faecorrigan/Open-Source-3-axis-CNC-Touch-Probe/README.md

# Open-Source-3-axis-CNC-Touch-Probe

This is a 3 axis cnc probe, principle development is done for the Makera Carvera

Features:
wireless communication between the probe and host via raw 802.15.4 packets
OTA firmware configuration and updates
wireless charging of on board lipo battery

The current development prototype in software uses the Arduino IDE with a seedstudio XIAO nrf52840 
Final hardware will be a custom nrf52840 circuit. 

the project currently is using public libraries from:
https://github.com/Tjoms99/xiao_sense_nrf52840_battery_lib
