faecorrigan/Open-Source-3-axis-CNC-Touch-Probe/Hardware/Circuit Boards/ballBearingBoard241112/buttonCircuitBoard241112.step

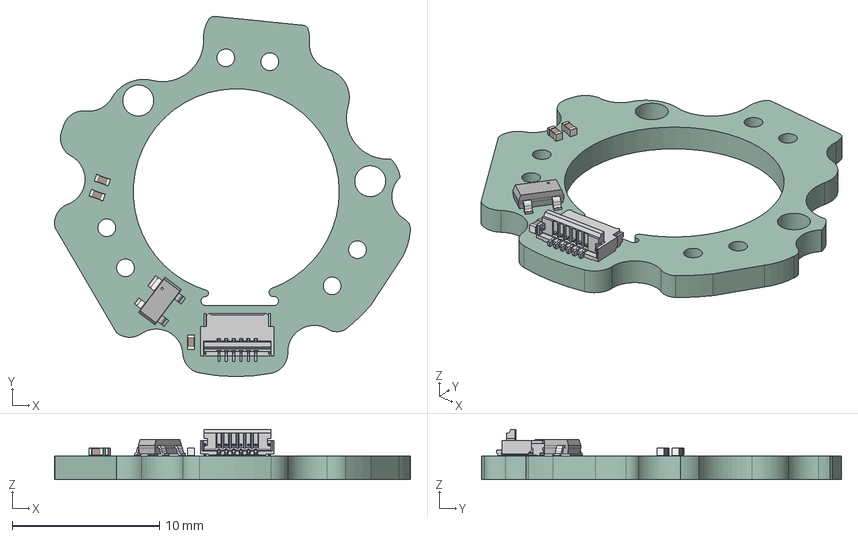
[picture p1: CAD file, 2025-11-08]
Hardware/Circuit Boards/ballBearingBoard241112/buttonCircuitBoard241112.step
24.2 x 24.5 x 3.42 mm
C_0402_1005Metric x 3
FH34SRJ-6S_ACTUATOROPEN.PRT
ballBearingBoard241112_PCB
