faecorrigan/Open-Source-3-axis-CNC-Touch-Probe/Hardware/Circuit Boards/BallBearingBoardPanelization/buttonCircuitBoard Vertical.step

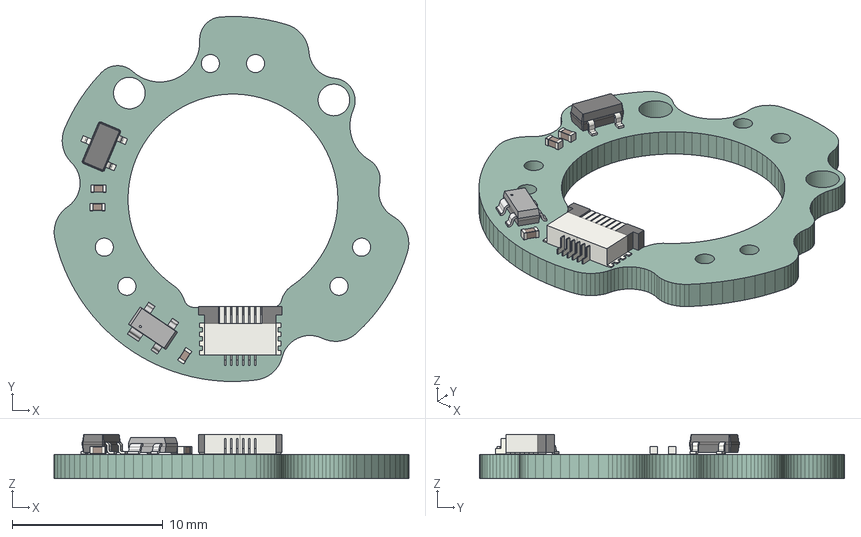
[picture p2: CAD file, 2025-11-08]
Hardware/Circuit Boards/BallBearingBoardPanelization/buttonCircuitBoard Vertical.step
23.6 x 24.2 x 2.95 mm
SC_59
C_0402_1005Metric x 3
TE_84953_6
bbsolderingTest PCB
