faecorrigan/Open-Source-3-axis-CNC-Touch-Probe/Hardware/Circuit Boards/ConnectionFPC/ballBearingFPC250213.step

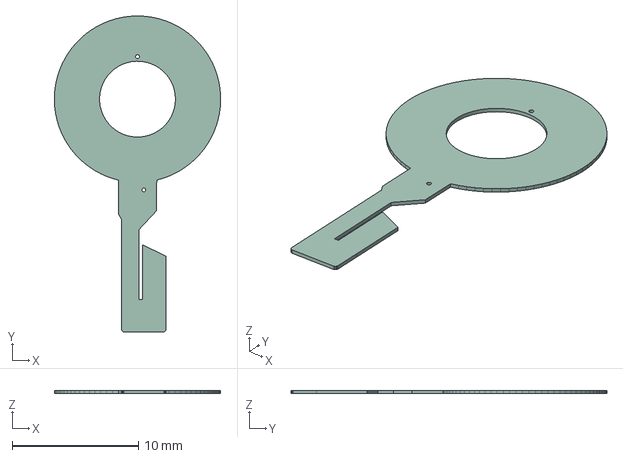
[picture p3: CAD file, 2025-11-08]
Hardware/Circuit Boards/ConnectionFPC/ballBearingFPC250213.step
13.2 x 25.0 x 0.233 mm
