faecorrigan/Open-Source-3-axis-CNC-Touch-Probe/Scratch/david/hardware/ball_coupling_test/v3_probe_ball_coupling_test.FCStd

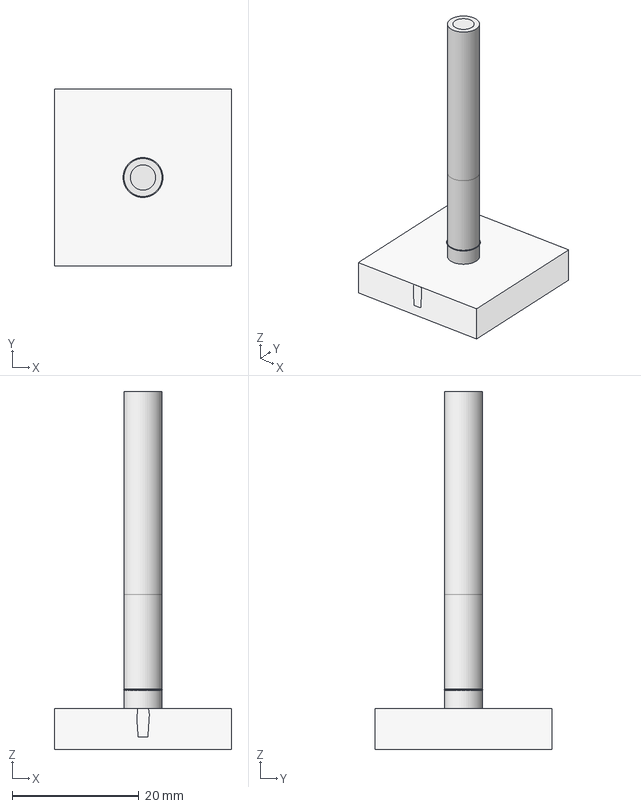
[picture p4: CAD file, 2024-04-26]
Scratch/david/hardware/ball_coupling_test/v3_probe_ball_coupling_test.FCStd
28.0 x 28.0 x 56.5 mm
Model-Body
Stock001
6mm_roughing_cut18mm
1mm_cut3mm
m2_neck6mm_threadmill
