faecorrigan/Open-Source-3-axis-CNC-Touch-Probe/Scratch/david/hardware/programming_board/v2/programming_board.FCStd

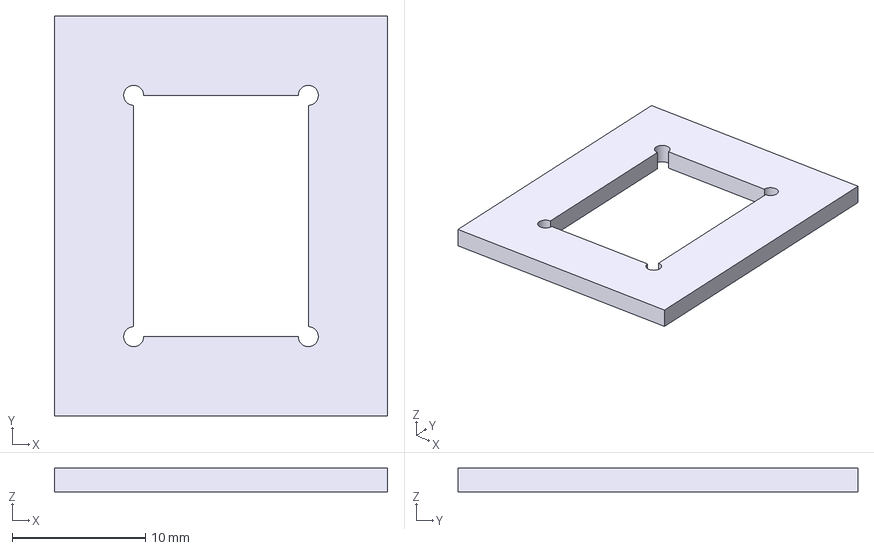
[picture p5: CAD file, 2024-06-06]
Scratch/david/hardware/programming_board/v2/programming_board.FCStd
25.0 x 30.0 x 1.80 mm
