faecorrigan/Open-Source-3-axis-CNC-Touch-Probe/Hardware/Circuit Boards/BallBearingBoardPanelization/buttonCircuitBoard241112.step

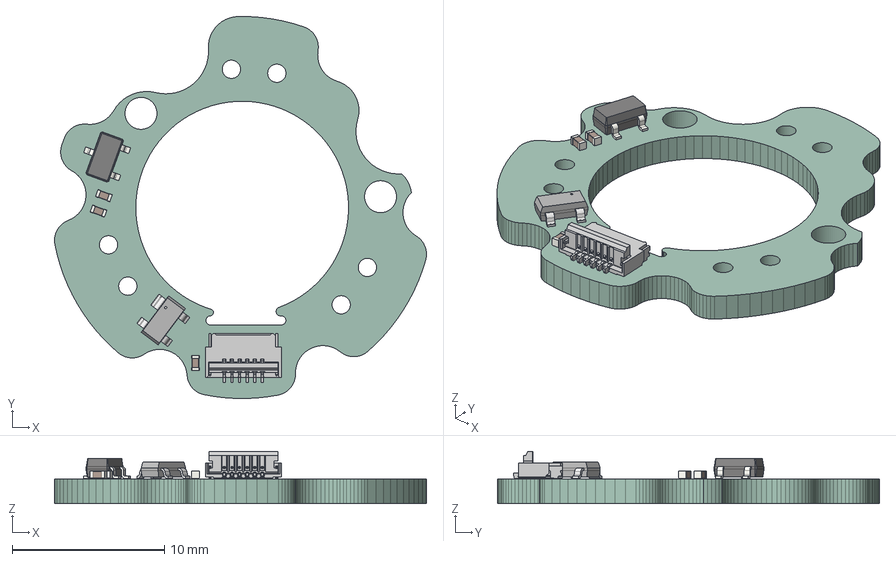
[picture p6: CAD file, 2025-11-08]
Hardware/Circuit Boards/BallBearingBoardPanelization/buttonCircuitBoard241112.step
24.5 x 25.1 x 3.42 mm
SC_59
C_0402_1005Metric x 3
FH34SRJ-6S_ACTUATOROPEN.PRT
ballBearingBoard241112 PCB
