faecorrigan/Open-Source-3-axis-CNC-Touch-Probe/Scratch/david/hardware/ball_coupling_test/V3 - Ball Holder.step

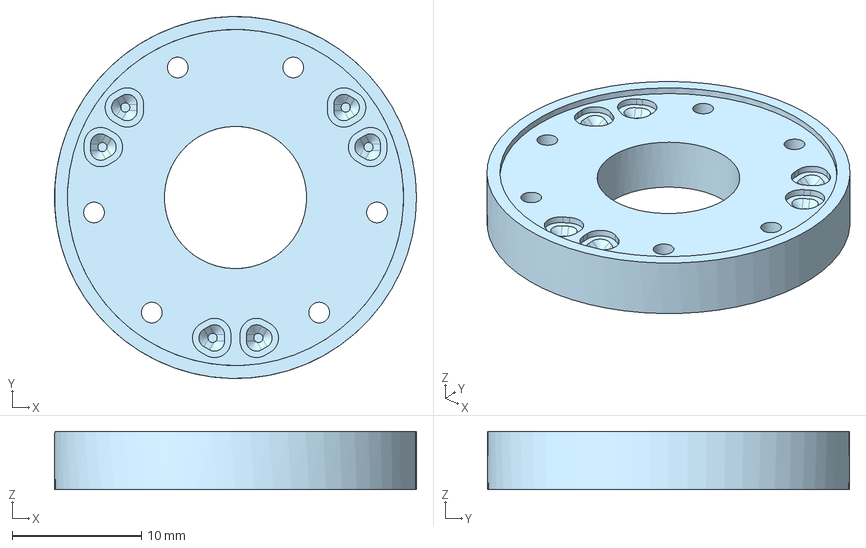
[picture p7: CAD file, 2024-04-23]
Scratch/david/hardware/ball_coupling_test/V3 - Ball Holder.step
28.0 x 28.0 x 4.50 mm
