faecorrigan/Open-Source-3-axis-CNC-Touch-Probe/Scratch/david/hardware/programming_board/v1/programming_board.FCStd

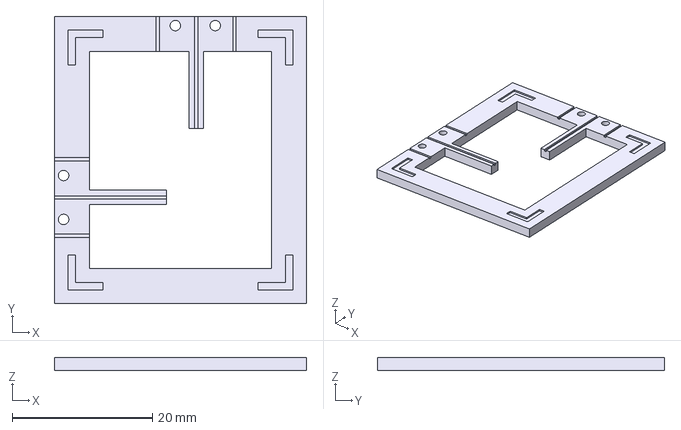
[picture p8: CAD file, 2024-06-06, an earlier design]
Scratch/david/hardware/programming_board/v1/programming_board.FCStd
36.0 x 41.0 x 1.80 mm
