faecorrigan/Open-Source-3-axis-CNC-Touch-Probe/(list of files, cad)

Other CAD files:
Hardware/Circuit Boards/BallBearingBoardPanelization/buttonCircuitBoard.step
Scratch/Fae/FusionPostProcessor/CarveraFusionPostProcessorTests.f3z
