faecorrigan/Open-Source-3-axis-CNC-Touch-Probe/Hardware/Circuit Boards/ConnectionFPC/ballBearingFPC250213.kicad_pcb

## KiCad design Hardware/Circuit Boards/ConnectionFPC/ballBearingFPC250213.kicad_pcb (2025-11-08)

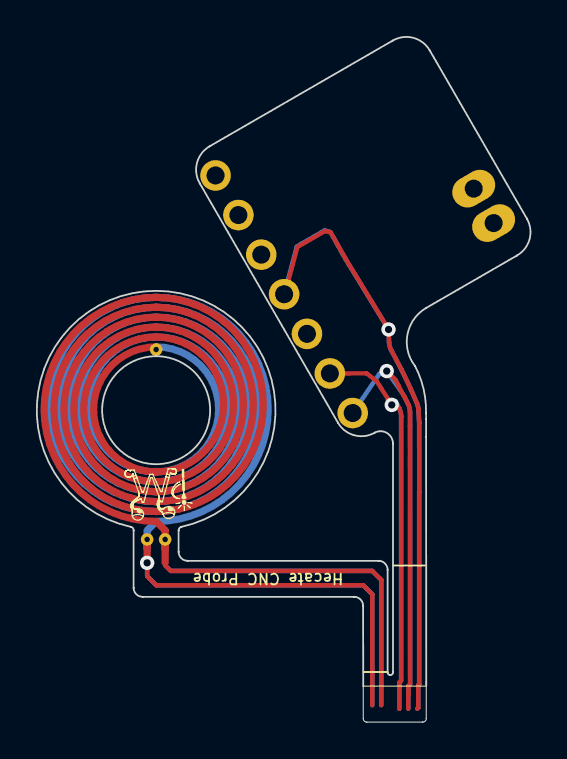
[picture p9: board ballBearingFPC250213.kicad_pcb from above]

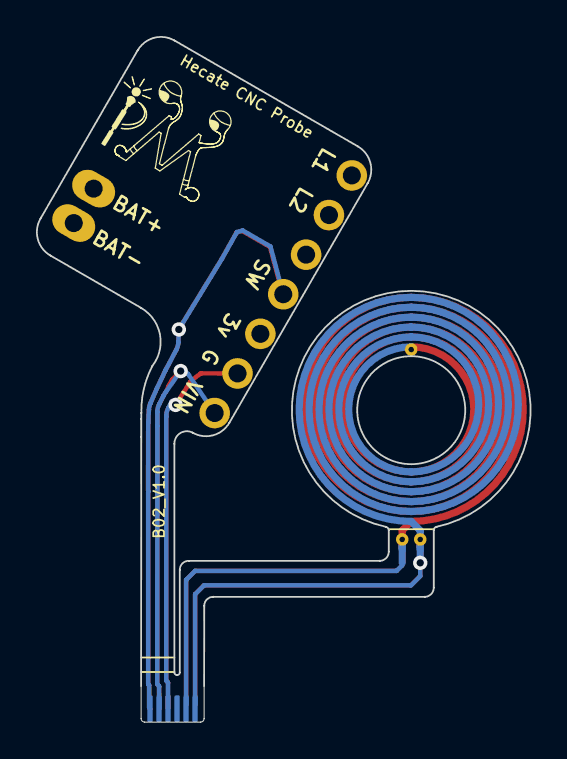
[picture p10: board ballBearingFPC250213.kicad_pcb from below]

Board: 2 copper layers, 27.4 x 38.1 mm, 11 parts (11 on the bottom side), 5 nets.

Parts:
J1: BB Board FPC Connection; FPC Cable End For JUSHUO AFH34 JLCPCP C5139821
J1#2: 3v; 2.54mm Flex PCB Solder Hole
J2: Xiao GND; 2.54mm Flex PCB Solder Hole
J3: Xiao VUSB; 2.54mm Flex PCB Solder Hole
J4: Xiao Switch; 2.54mm Flex PCB Solder Hole
J5: Las01; 2.54mm Flex PCB Solder Hole
J6: Las02; 2.54mm Flex PCB Solder Hole
J7: Empty; 2.54mm Flex PCB Solder Hole
J8: Bat+; 2.54mm Flex PCB Solder Hole
J9: Bat-; 2.54mm Flex PCB Solder Hole
L2: Wireless Charging Coil; COIL_GENERATOR_1

Connections:
unnamed: J1.1, J1#2.1, J4.1
unnamed: J1.2, J3.1
unnamed: J1.3, J2.1
unnamed: J1.5, L2.2
unnamed: J1.6, L2.1
