faecorrigan/Open-Source-3-axis-CNC-Touch-Probe/Hardware/Circuit Boards/ballBearingBoard241112/ballBearingBoard241112.kicad_pcb

## KiCad design Hardware/Circuit Boards/ballBearingBoard241112/ballBearingBoard241112.kicad_pcb (2025-11-08)

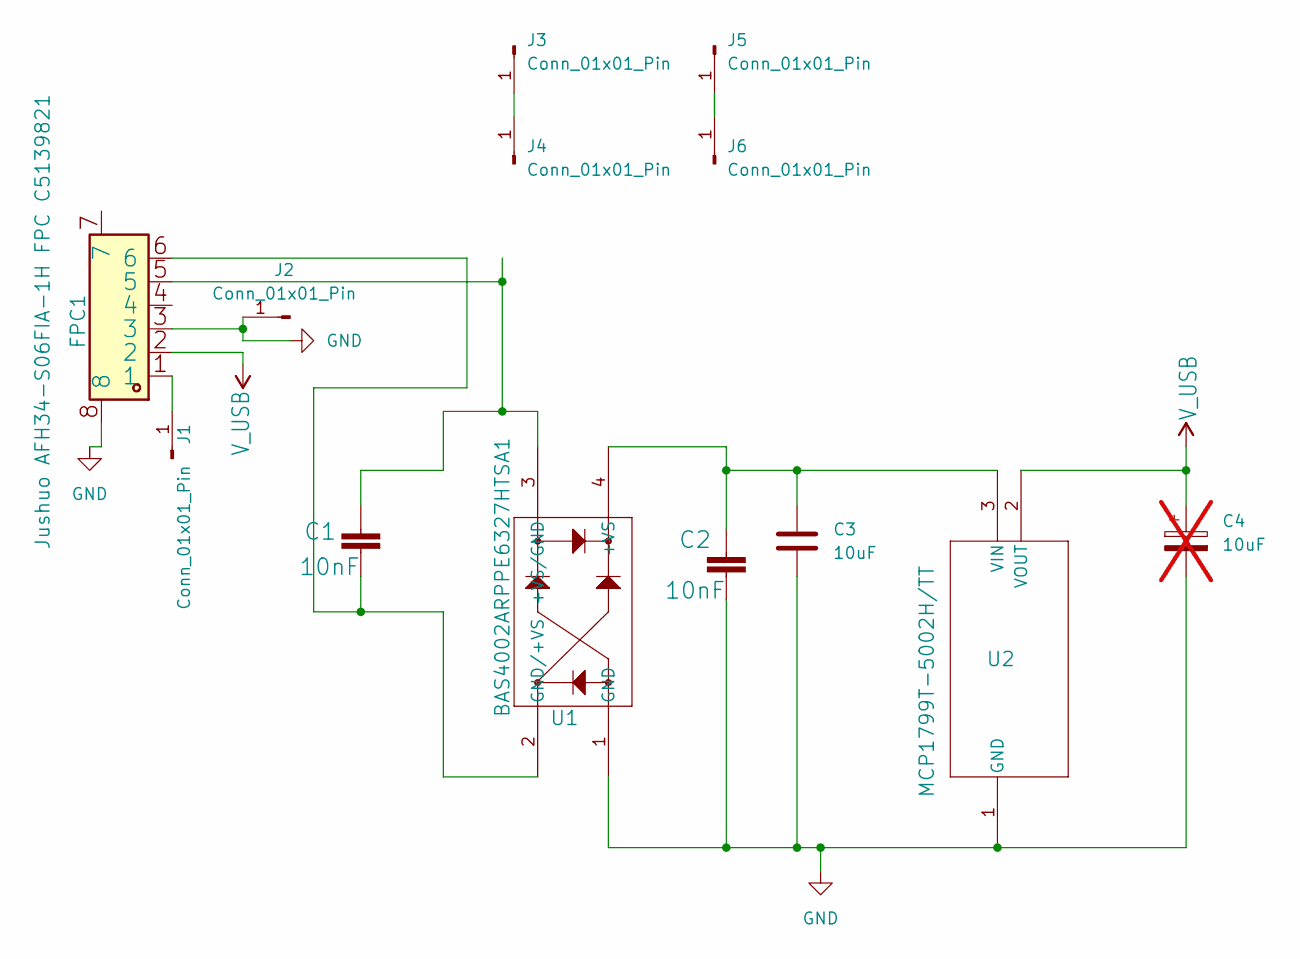
[picture p11: schematic ballBearingBoard241112.kicad_sch]

Parts:
C1, C2: 10nF; C_0402_1005Metric; LCSC C15195
C3: 10uF; C_0402_1005Metric; LCSC C15195
C4: 10uF; C_0603_1608Metric; not fitted
FPC1: Jushuo AFH34-S06FIA-1H FPC C5139821; LCSC C5139821
J1, J2, J3, J4, J5, J6: Conn_01x01_Pin; 0.0625 ball bearing mouting pad
U1: BAS4002ARPPE6327HTSA1; SOT143_BAS4002ARPPE6327HTSA1_INF; LCSC C3589694
U2: MCP1799T-5002H/TT; SOT-23_TT_MCH; LCSC C2890492

Connections:
GND: C2.2, C3.2, C4.2, FPC1.3, FPC1.8, J2.1, U1.1 (GND), U2.1 (GND)
unnamed: FPC1.1, J1.1
unnamed: J3.1, J4.1
unnamed: J5.1, J6.1
unnamed: C2.1, C3.1, U1.4 (+VS), U2.3 (VIN)
unnamed: C1.1, FPC1.5, U1.3 (+VS/GND)
unnamed: C1.2, FPC1.6, U1.2 (GND/+VS)
V_USB: C4.1, FPC1.2, U2.2 (VOUT)

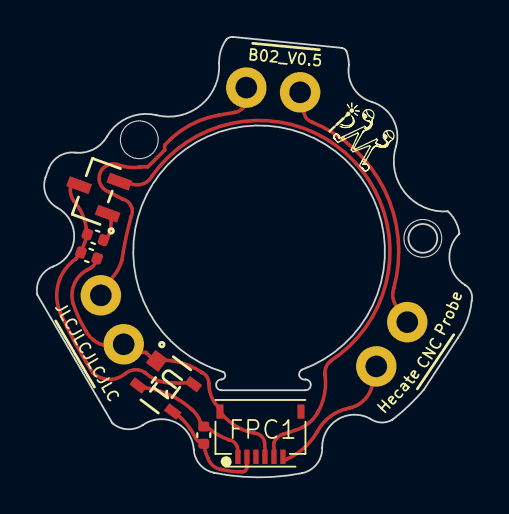
[picture p12: board ballBearingBoard241112.kicad_pcb from above]

Board: 2 copper layers, 24.2 x 24.5 mm, 12 parts (0 on the bottom side), 8 nets.
