faecorrigan/Open-Source-3-axis-CNC-Touch-Probe/Hardware/Circuit Boards/BallBearingBoardPanelization/ballBearingBoardPanelization241112.kicad_pcb

## KiCad design Hardware/Circuit Boards/BallBearingBoardPanelization/ballBearingBoardPanelization241112.kicad_pcb (2025-11-08)

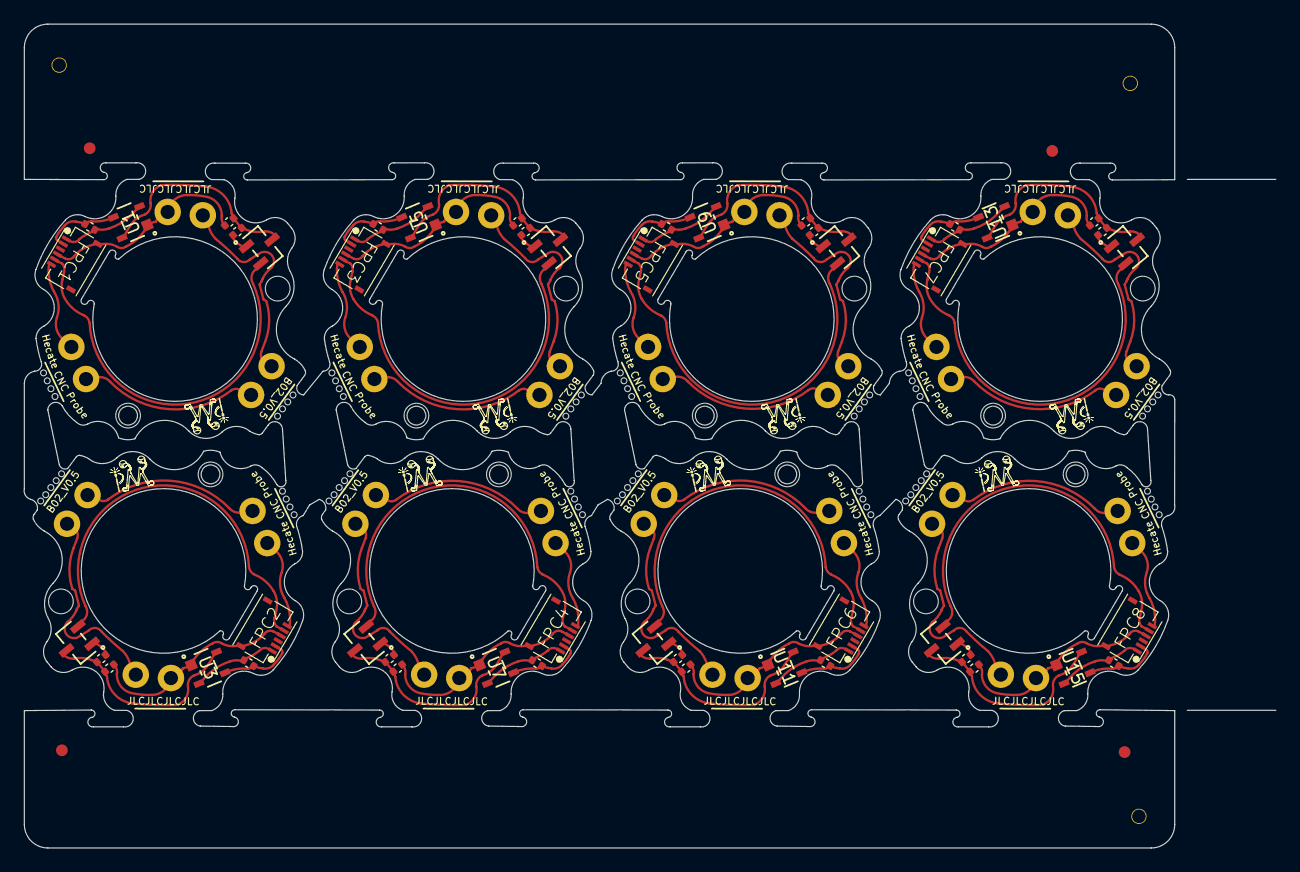
[picture p13: board ballBearingBoardPanelization241112.kicad_pcb from above]

Board: 2 copper layers, 106.4 x 70.0 mm, 147 parts (0 on the bottom side), 8 nets.

Parts:
1, 2, 3, 4, 5, 6, 7, 8, 9, 10, 11, 12, 13, 14, 15, 16, 17, 18, 19, 20, 21, 22, 23, 24, 25, 26, 27, 28, 29, 30, 31, 32, 33, 34, 35, 36, 37, 38, 39, 40, 41, 42, 43, 44, 45, 46, 47, 48, 49, 50, 51: (no value)
C1, C2, C5, C6, C7, C8, C11, C12, C13, C14, C17, C18, C19, C20, C23, C24: 10nF; C_0402_1005Metric
C3, C4, C9, C10, C15, C16, C21, C22: 10uF; C_0402_1005Metric
FPC1, FPC2, FPC3, FPC4, FPC5, FPC6, FPC7, FPC8: XUNPU_FPC-05F-6PH20_JLCPCB_C2856796; Jushuo AFH34-S06FIA-1H FPC C5139821
J1, J1#2, J2, J2#2, J3, J3#2, J4, J4#2, J5, J5#2, J6, J6#2, J7, J8, J9, J10, J11, J12, J13, J14, J15, J16, J17, J18, J19, J20, J21, J22, J23, J24, J25, J26, J27, J28, J29, J30, J31, J32, J33, J34, J35, J36, J37, J38, J39, J40, J41, J42: Conn_01x01_Pin; 0.0625 ball bearing mouting pad
U1, U3, U5, U7, U9, U11, U13, U15: BAS4002ARPPE6327HTSA1; SOT143_BAS4002ARPPE6327HTSA1_INF
U2, U4, U6, U8, U10, U12, U14, U16: MCP1799T-5002H/TT; SOT-23_TT_MCH

Connections:
GND: C2.2, C3.2, C4.2, C5.2, C8.2, C9.2, C10.2, C11.2, C14.2, C15.2, C16.2, C17.2, C20.2, C21.2, C22.2, C23.2, FPC1.3, FPC1.8, FPC2.3, FPC2.8, FPC3.3, FPC3.8, FPC4.3, FPC4.8, FPC5.3, FPC5.8, FPC6.3, FPC6.8, FPC7.3, FPC7.8, FPC8.3, FPC8.8, J2.1, J2#2.1, J9.1, J10.1, J21.1, J22.1, J33.1, J34.1, U1.1 (GND), U2.1 (GND), U3.1 (GND), U4.1 (GND), U5.1 (GND), U6.1 (GND), U7.1 (GND), U8.1 (GND), U9.1 (GND), U10.1 (GND), U11.1 (GND), U12.1 (GND), U13.1 (GND), U14.1 (GND), U15.1 (GND), U16.1 (GND)
unnamed: FPC1.1, FPC2.1, FPC3.1, FPC4.1, FPC5.1, FPC6.1, FPC7.1, FPC8.1, J1.1, J1#2.1, J7.1, J8.1, J19.1, J20.1, J31.1, J32.1
unnamed: J3.1, J3#2.1, J4.1, J4#2.1, J11.1, J12.1, J13.1, J14.1, J23.1, J24.1, J25.1, J26.1, J35.1, J36.1, J37.1, J38.1
unnamed: J5.1, J5#2.1, J6.1, J6#2.1, J15.1, J16.1, J17.1, J18.1, J27.1, J28.1, J29.1, J30.1, J39.1, J40.1, J41.1, J42.1
unnamed: C2.1, C3.1, C4.1, C5.1, C8.1, C9.1, C10.1, C11.1, C14.1, C15.1, C16.1, C17.1, C20.1, C21.1, C22.1, C23.1, U1.4 (+VS), U2.3 (VIN), U3.4 (+VS), U4.3 (VIN), U5.4 (+VS), U6.3 (VIN), U7.4 (+VS), U8.3 (VIN), U9.4 (+VS), U10.3 (VIN), U11.4 (+VS), U12.3 (VIN), U13.4 (+VS), U14.3 (VIN), U15.4 (+VS), U16.3 (VIN)
unnamed: C1.1, C6.1, C7.1, C12.1, C13.1, C18.1, C19.1, C24.1, FPC1.5, FPC2.5, FPC3.5, FPC4.5, FPC5.5, FPC6.5, FPC7.5, FPC8.5, U1.3 (+VS/GND), U3.3 (+VS/GND), U5.3 (+VS/GND), U7.3 (+VS/GND), U9.3 (+VS/GND), U11.3 (+VS/GND), U13.3 (+VS/GND), U15.3 (+VS/GND)
unnamed: C1.2, C6.2, C7.2, C12.2, C13.2, C18.2, C19.2, C24.2, FPC1.6, FPC2.6, FPC3.6, FPC4.6, FPC5.6, FPC6.6, FPC7.6, FPC8.6, U1.2 (GND/+VS), U3.2 (GND/+VS), U5.2 (GND/+VS), U7.2 (GND/+VS), U9.2 (GND/+VS), U11.2 (GND/+VS), U13.2 (GND/+VS), U15.2 (GND/+VS)
V_USB: FPC1.2, FPC2.2, FPC3.2, FPC4.2, FPC5.2, FPC6.2, FPC7.2, FPC8.2, U2.2 (VOUT), U4.2 (VOUT), U6.2 (VOUT), U8.2 (VOUT), U10.2 (VOUT), U12.2 (VOUT), U14.2 (VOUT), U16.2 (VOUT)
