faecorrigan/Open-Source-3-axis-CNC-Touch-Probe/(commit log)

2024-04-22 initial push of early prototype from Fae
    there will be further updates for hardware and circuit boards this week
    [Carvera 3 Axis Touch Probe v95.f3z, Carvera3AxisWirelessProbeMk1.kicad_pcb, Carvera3AxisWirelessProbeMk1.kicad_sch, Carvera3AxisWirelessProbeMk1.step, buttonCircuitBoard.kicad_pcb, buttonCircuitBoard.kicad_sch, buttonCircuitBoard.step, flexibleWirelessCharger.kicad_pcb]
2024-04-22 initial commit: dump probe captures and analysis script
2024-04-22 initial commit: bare metal arm firmware for the probe
2024-04-22 makera carvera fusion post processor for scratch drive
    [CarveraFusionPostProcessorTests.f3z]
2024-04-23 test for kinematic mounts for ball bearings + circuit board contact
    [V3 - Ball Holder.step, v3_probe_ball_coupling_test.FCStd]
2024-04-24 wip probe state machine
2024-04-26 update analyze script to print packet information more cleanly
2024-04-27 call and response pairing example
    gets very close but fails to actually finish pairing. There are some shenanigans happening on channel 26 that could be the culprit
    [CallAndResponse.ino, NRF52840_HexToName.h, tests.h]
2024-04-27 current probe firmware test
2024-05-17 updating core firmware for probe
2024-06-06 programming board
    [programming_board.FCStd]
2024-11-11 Sleep mode update
    fixing some hiccups with sleep mode disabling pairing mode/sending packets in general.
    Current bugs to squash:
    deep sleep mode is triggered but never entered properly. It just lives in the infinite loop printing "off"
    This appears to be a problem with idlemode as the deep sleep works when entered directly via another method
    idle mode is not polling the probe pin frequently enough. It will only wake up if the probe is triggered while it is sending a heartbeat.
    We should consider setting up the probe pin as an interrupt when it is in idle mode.
    [CarveraOpenSourceProbeFirmware.ino, NRF52840_HexToName.h]
2024-11-11 sleep mode button interrupt fix
    [CarveraOpenSourceProbeFirmware.ino]
2025-01-20 add optional pin number overrides
2025-01-20 add more optional pin number overrides
2025-01-20 clean up sleep/interrupt handling code
2025-01-20 configure laser pins for output
2025-01-20 safety check to ensure lasers are off while sleeping
    I think this changes nothing under default configuration, but if a user
    configures a longer laserDelay than idleDelay (invalid configuration)
    it's important. Also generally just good hygiene
2025-01-28 fix millis()
2025-01-29 implement mill-initiated laser on command
2025-02-02 send heart beats during probe active mode if it's time, including first heartbeat after power on
2025-02-03 make sequence number behavior match stock probe
2025-02-04 rewrite handling of seq to match carvera behavior. Increase probe packet rate to match too
2025-02-08 match probe 0x06 behavior: read battery and send 0x06 after every wake from idle
2025-02-11 check at the beginning of pairing cycle if the button is pressed
2025-02-11 low power peripherals: external-only button pullup and only enable vbat_read when using it
2025-02-13 implement low power mode, validate pair, trigger, heart beat, laser functions
2025-11-08 Updating Probe Circuit Boards to Latest
    [Carvera 3 Axis Touch Probe v95.f3z, Carvera3AxisWirelessProbeMk1.kicad_pcb, Carvera3AxisWirelessProbeMk1.kicad_sch, Carvera3AxisWirelessProbeMk1.step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]
